polygon/mididude/case/case-Bottom.stl

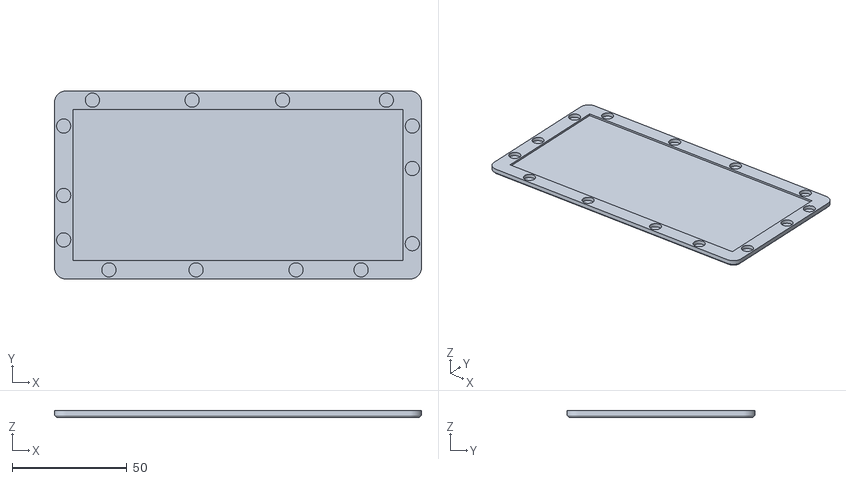
[picture p1: CAD file, 2025-07-23]
case/case-Bottom.stl
160.0 x 82.0 x 3.20
