polygon/mididude/case/case-Top.stl

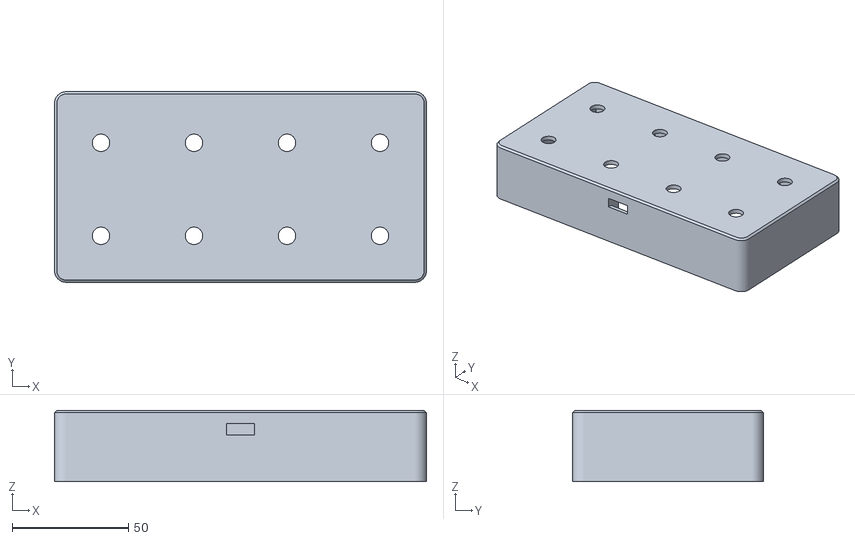
[picture p2: CAD file, 2025-07-23]
case/case-Top.stl
160.0 x 82.0 x 30.7
