polygon/mididude/case/case.FCStd

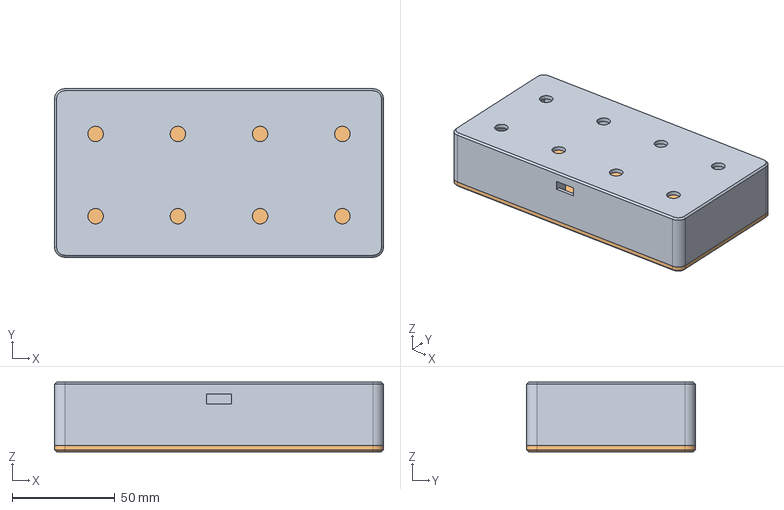
[picture p3: CAD file, 2025-07-23]
case/case.FCStd
160.0 x 82.0 x 33.9 mm
Top
