polygon/mididude/(list of files, cad)

Other CAD files:
case/case.3mf
