polygon/mididude/board/mididude/mididude.kicad_pcb

## KiCad design board/mididude/mididude.kicad_pcb (2025-07-19)

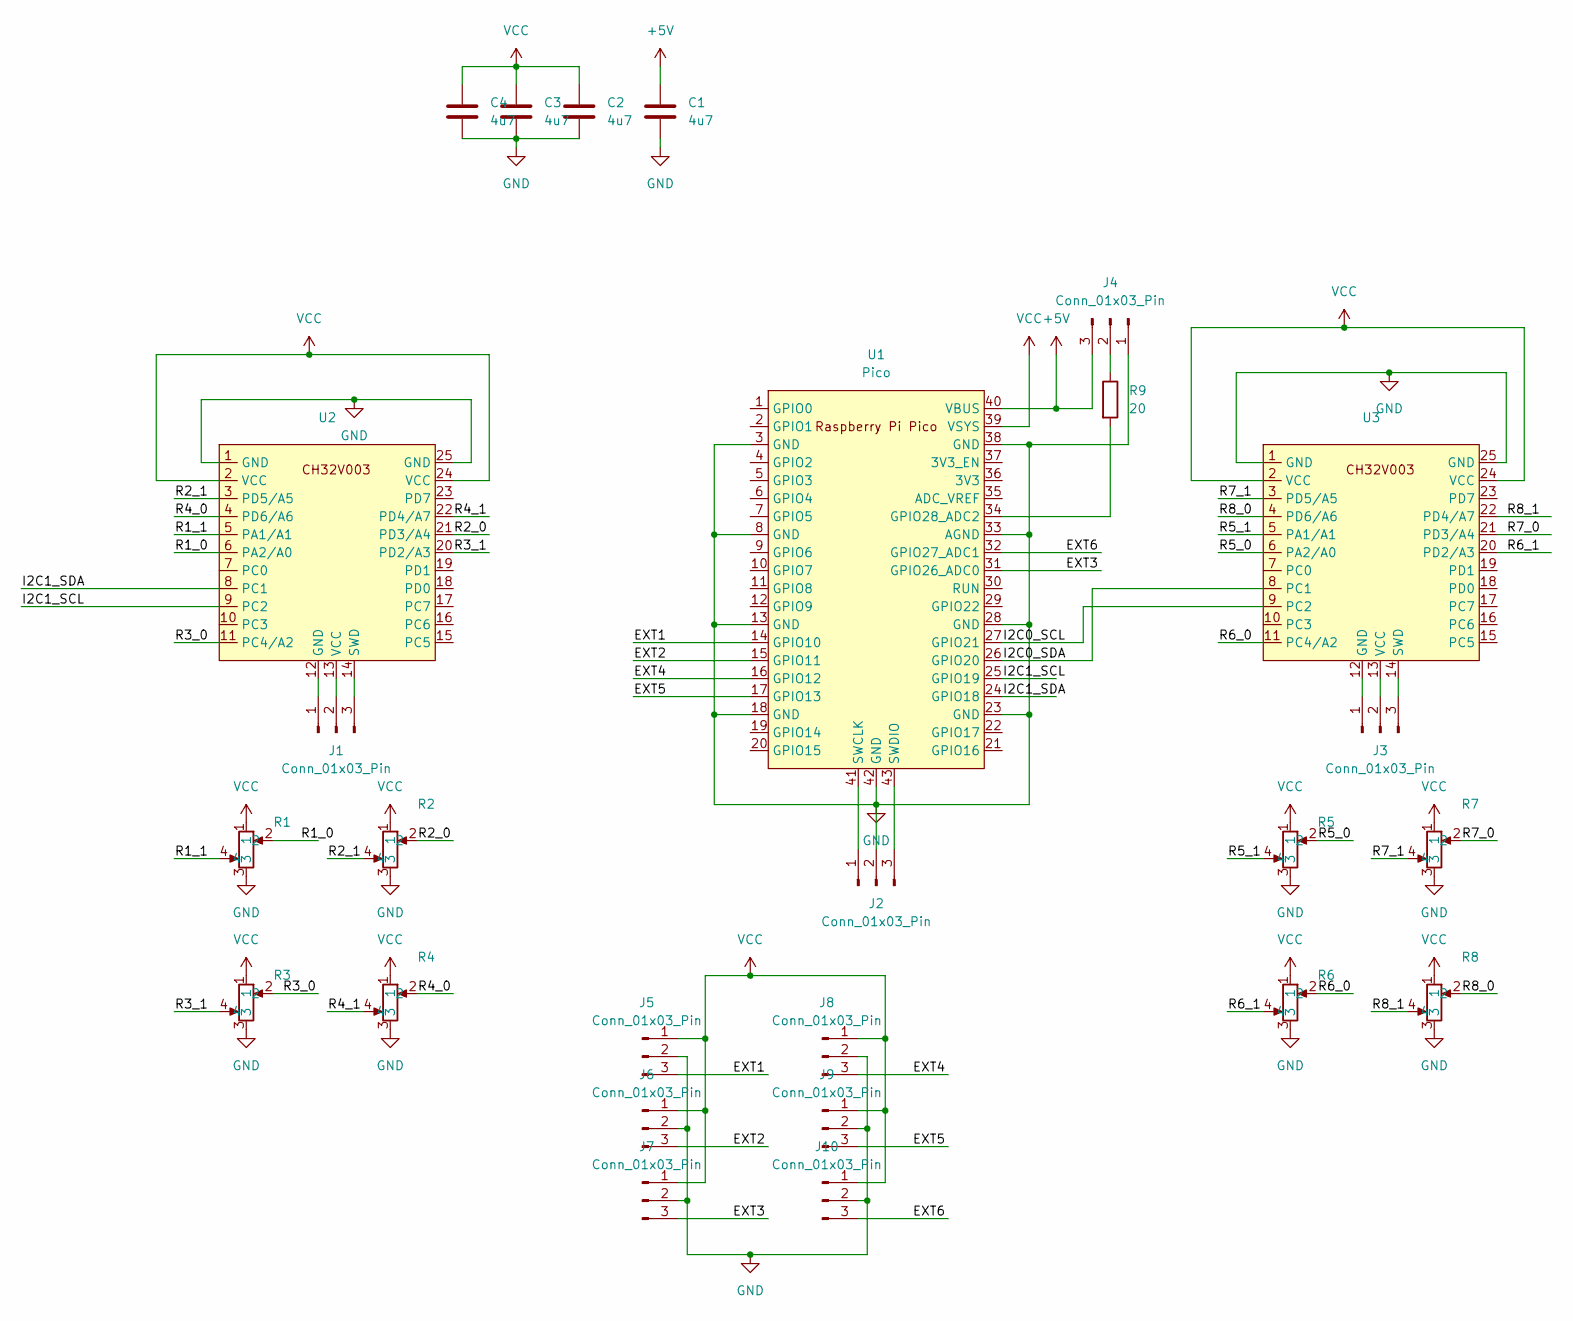
[picture p4: schematic mididude.kicad_sch]

Parts:
C1, C2, C3, C4: 4u7; C_0805_2012Metric_Pad1.18x1.45mm_HandSolder
J1, J2, J3, J4, J5, J6, J7, J8, J9, J10: Conn_01x03_Pin; PinHeader_1x03_P2.54mm_Vertical
R1, R2, R3, R4, R5, R6, R7, R8: Endless_potentiometer
R9: 20; R_0603_1608Metric_Pad0.98x0.95mm_HandSolder
U1: Pico; RPi_Pico_SMD_TH
U2, U3: CH32FV003 F1772

Connections:
+5V: C1.1, J4.3, U1.40 (VBUS)
/EXT1: J5.3, U1.14 (GPIO10)
/EXT2: J6.3, U1.15 (GPIO11)
/EXT3: J7.3, U1.31 (GPIO26_ADC0)
/EXT4: J8.3, U1.16 (GPIO12)
/EXT5: J9.3, U1.17 (GPIO13)
/EXT6: J10.3, U1.32 (GPIO27_ADC1)
/I2C0_SCL: U1.27 (GPIO21), U3.9 (PC2)
/I2C0_SDA: U1.26 (GPIO20), U3.8 (PC1)
/I2C1_SCL: U1.25 (GPIO19), U2.9 (PC2)
/I2C1_SDA: U1.24 (GPIO18), U2.8 (PC1)
/R1_0: R1.2, U2.6 (PA2/A0)
/R1_1: R1.4, U2.5 (PA1/A1)
/R2_0: R2.2, U2.21 (PD3/A4)
/R2_1: R2.4, U2.3 (PD5/A5)
/R3_0: R3.2, U2.11 (PC4/A2)
/R3_1: R3.4, U2.20 (PD2/A3)
/R4_0: R4.2, U2.4 (PD6/A6)
/R4_1: R4.4, U2.22 (PD4/A7)
/R5_0: R5.2, U3.6 (PA2/A0)
/R5_1: R5.4, U3.5 (PA1/A1)
/R6_0: R6.2, U3.11 (PC4/A2)
/R6_1: R6.4, U3.20 (PD2/A3)
/R7_0: R7.2, U3.21 (PD3/A4)
/R7_1: R7.4, U3.3 (PD5/A5)
/R8_0: R8.2, U3.4 (PD6/A6)
/R8_1: R8.4, U3.22 (PD4/A7)
GND: C1.2, C2.2, C3.2, C4.2, J2.2, J4.1, J5.2, J6.2, J7.2, J8.2, J9.2, J10.2, R1.3, R2.3, R3.3, R4.3, R5.3, R6.3, R7.3, R8.3, U1.3 (GND), U1.8 (GND), U1.13 (GND), U1.18 (GND), U1.23 (GND), U1.28 (GND), U1.33 (AGND), U1.38 (GND), U1.42 (GND), U2.1 (GND), U2.25 (GND), U3.1 (GND), U3.25 (GND)
unnamed: J1.1, U2.12 (GND)
unnamed: J1.2, U2.13 (VCC)
unnamed: J1.3, U2.14 (SWD)
unnamed: J2.1, U1.41 (SWCLK)
unnamed: J2.3, U1.43 (SWDIO)
unnamed: J3.1, U3.12 (GND)
unnamed: J3.2, U3.13 (VCC)
unnamed: J3.3, U3.14 (SWD)
unnamed: J4.2, R9.1
unnamed: R9.2, U1.34 (GPIO28_ADC2)
VCC: C2.1, C3.1, C4.1, J5.1, J6.1, J7.1, J8.1, J9.1, J10.1, R1.1, R2.1, R3.1, R4.1, R5.1, R6.1, R7.1, R8.1, U1.39 (VSYS), U2.2 (VCC), U2.24 (VCC), U3.2 (VCC), U3.24 (VCC)

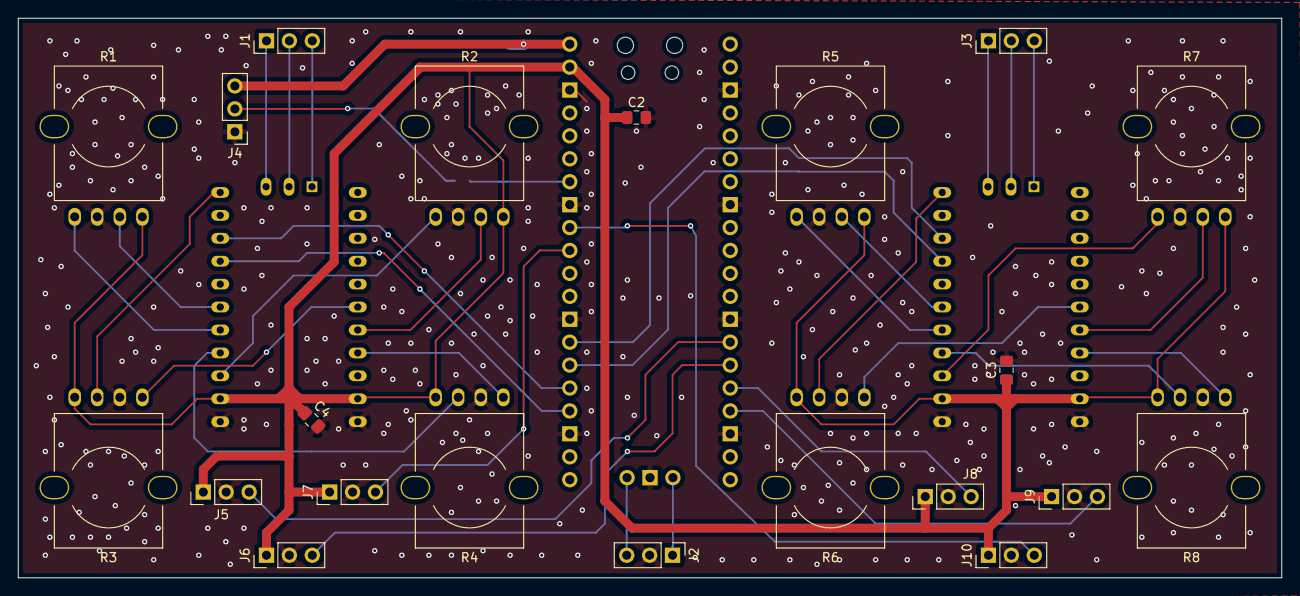
[picture p5: board mididude.kicad_pcb from above]

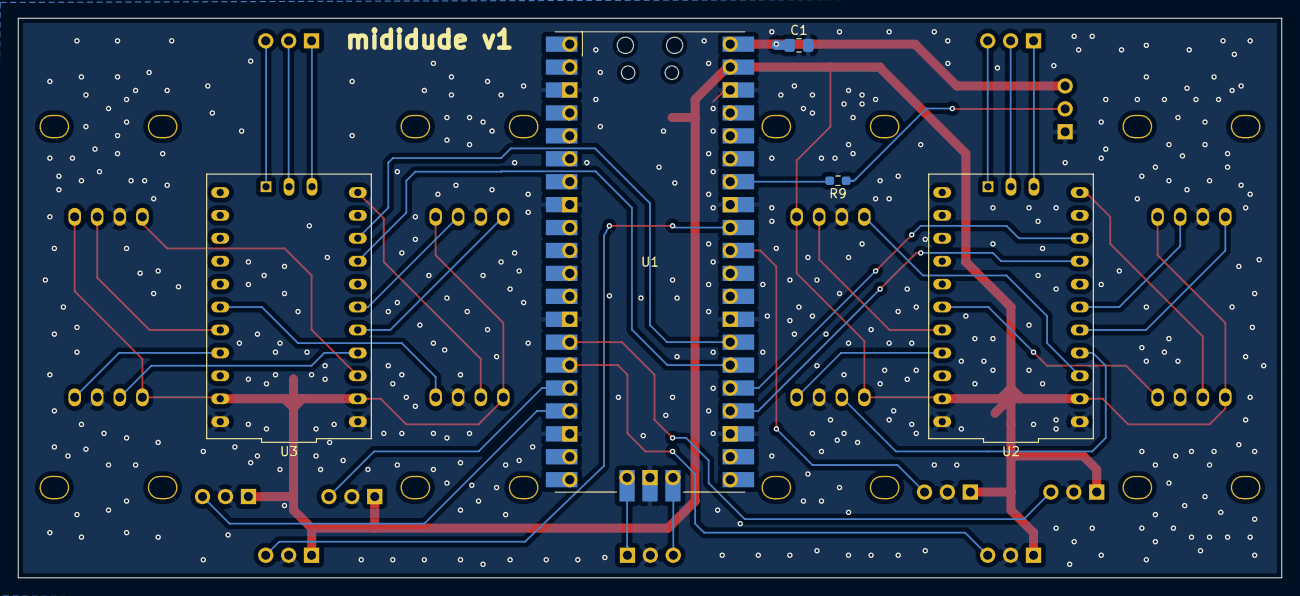
[picture p6: board mididude.kicad_pcb from below]

Board: 2 copper layers, 140.0 x 62.0 mm, 26 parts (5 on the bottom side), 39 nets.
