polygon/mididude/(commit log)

2025-07-19 Mididude Init
    * Board Design
    * CH32 I2C ADC Expander Code
    * Basic USB-MIDI-Device RP-Pico code
    [mididude.kicad_pcb, mididude.kicad_sch]
2025-07-20 Fix CH32 glitches, improve FW
    [blinky.rs, i2c_device.rs, main.rs]
2025-07-20 Pretty good firmware
    [mididude.kicad_sch]
2025-07-21 Ensure USB is polled even if nothing moves on the device
2025-07-23 Whole case, v1
    [case-Bottom.stl, case-Top.stl, case.3mf, case.FCStd]
